anfroholic/eurosynth/README.md

# EuroSynth 🎛️🔊

A **kitchen-sink synthesizer voice in custom silicon** — a fully digital eurorack
synth voice taped out on the open-source **GlobalFoundries 180 nm (GF180MCU)** PDK with
the LibreLane RTL-to-GDSII flow.

<p align="center">
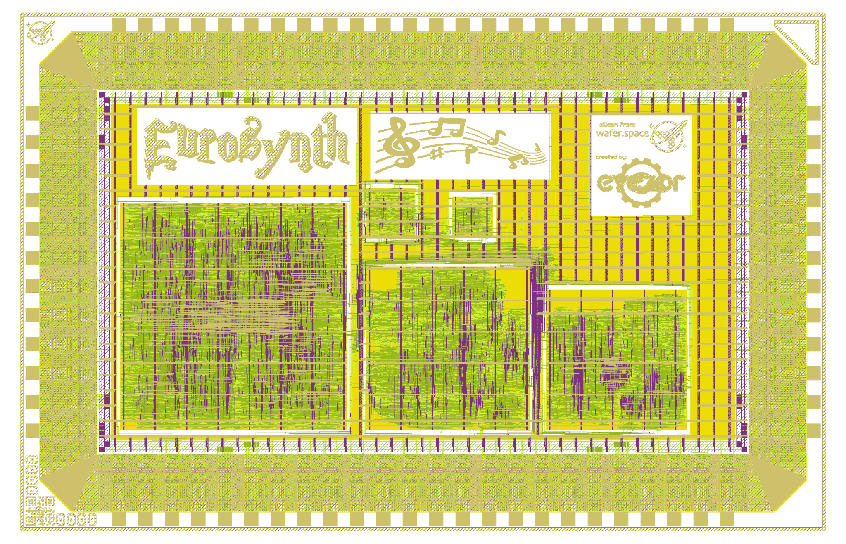
[picture p1: docs/img/die_render.png]
EuroSynth die render
  
</p>

A small, bulletproof **spine** owns the audio timing, mixes a bank of **isolated sound
engines**, and streams 16-bit audio to an external DAC. Engine #1 — a **Karplus-Strong
plucked string** — is verified *bit-exact* against a golden reference and hardened to a
**clean, manufacturable GDSII**:

> **DRC = 0 · LVS = 0 · antenna = 0 · power-grid = 0** — manufacturability report all-pass.
> Die 3.93 mm × 2.53 mm (9.95 mm²), 66,906 standard cells, 5 V.

### 🎧 Hear it in your browser

**▶ [Live playground → anfroholic.github.io/eurosynth/web](https://anfroholic.github.io/eurosynth/web/)**
— all five voices running live, no install. It executes the chip's **bit-exact integer
reference models** (`models/*_ref.py`) in WebAssembly via [PyScript](https://pyscript.net),
so what you hear is sample-for-sample what the silicon produces. Source: [web/](web/).

## 📖 Documentation

| Doc | What's in it |
|---|---|
| **[🎧 Live playground](https://anfroholic.github.io/eurosynth/web/)** | The chip's voices running in your browser — bit-exact reference models compiled to WebAssembly (PyScript). Source in [web/](web/). |
| **[docs/SHOWCASE.md](docs/SHOWCASE.md)** | The flagship write-up: what it is, the silicon achievement & signoff, architecture, the Karplus-Strong engine, specs, and pinout. **Start here.** |
| **[docs/HARDWARE_GUIDE.md](docs/HARDWARE_GUIDE.md)** | Build it: power/clock/reset, a sample circuit for **every pad**, a "hello world" first-light test, two audio output options, and a ready-to-run Arduino controller. |
| **[NOTES.md](NOTES.md)** | Design rationale — *why* it looks the way it does; the engine contract; the roadmap. |
| **[docs/karplus_strong.md](docs/karplus_strong.md)** | The KS engine spec: integer algorithm, fixed-point analysis, golden-vector test plan. |
| **[PLAN.md](PLAN.md) · [PROGRESS.md](PROGRESS.md)** | Build plan and the full status log (incl. the GDSII hardening run). |

## 🗂️ Source

| Path | Role |
|---|---|
| [src/synth_spine.sv](src/synth_spine.sv) | Timing spine: tick gen, voice mux, I2S serializer, bypass ramp |
| [src/ks_engine.sv](src/ks_engine.sv) | Karplus-Strong plucked-string engine |
| [src/chip_core.sv](src/chip_core.sv) | Pad-interface wiring (the `1x0p5` pin map) |
| [src/chip_top.sv](src/chip_top.sv) | Template top / I/O pad ring |
| [models/ks_ref.py](models/ks_ref.py) · [models/ks_golden.hex](models/ks_golden.hex) | Bit-exact reference model + golden vector |
| [tb/](tb/) | Self-checking testbenches (KS golden, spine round-trip, elaboration) |

## ⚡ 5-Minute Quickstart

> **Built on [@evezor's wafer.space Docker starter kit](https://github.com/evezor/wafer_space_docker_based_starter_kit)** —
> a beginner-friendly GF180MCU + wafer.space tutorial (itself built on the
> [wafer.space gf180mcu-project-template](https://github.com/wafer-space/gf180mcu-project-template)).
> EuroSynth uses that kit's exact Docker flow. **New to silicon? Do that tutorial first.**

The fastest path from nothing to a green simulation — proof the whole thing works
on your machine. You need only `docker` + `docker compose` (and `make`).

```bash
# 1. Get the code
git clone https://github.com/anfroholic/eurosynth.git
cd eurosynth

# 2. Build the simulation image (one-time; a few minutes)
make build-sim

# 3. Simulate the chip — the moment of truth
make sim
```

> ✅ **Green light:** `make sim` ends with `ALL STANDALONE TBS PASSED` and exits 0.
> If you got here, the kit works on your machine.

### Optional — produce a real layout

```bash
make pdk        # fetch the GF180MCU PDK (multi-GB, one-time)
make harden     # RTL → GDSII for the default slot (takes a while)
```

After `make harden`, the signed-off layout lands in `final/` — check
`final/manufacturability.rpt` (DRC / LVS / antenna) and `final/gds/chip_top.gds`.

> **No `make`?** On native Windows the same steps are the script wrappers:
> `bash scripts/sim_all.sh`, `bash scripts/pdk.sh`, `bash scripts/harden.sh`.

## 🛠️ Built with

GF180MCU PDK · LibreLane · OpenROAD · Yosys · Magic · KLayout · Netgen.

## 📜 License

Apache-2.0 (see [LICENSE](LICENSE) and [AUTHORS.md](AUTHORS.md)).
