anfroholic/eurosynth/docs/img/art_samples/00_source_greyscale.png

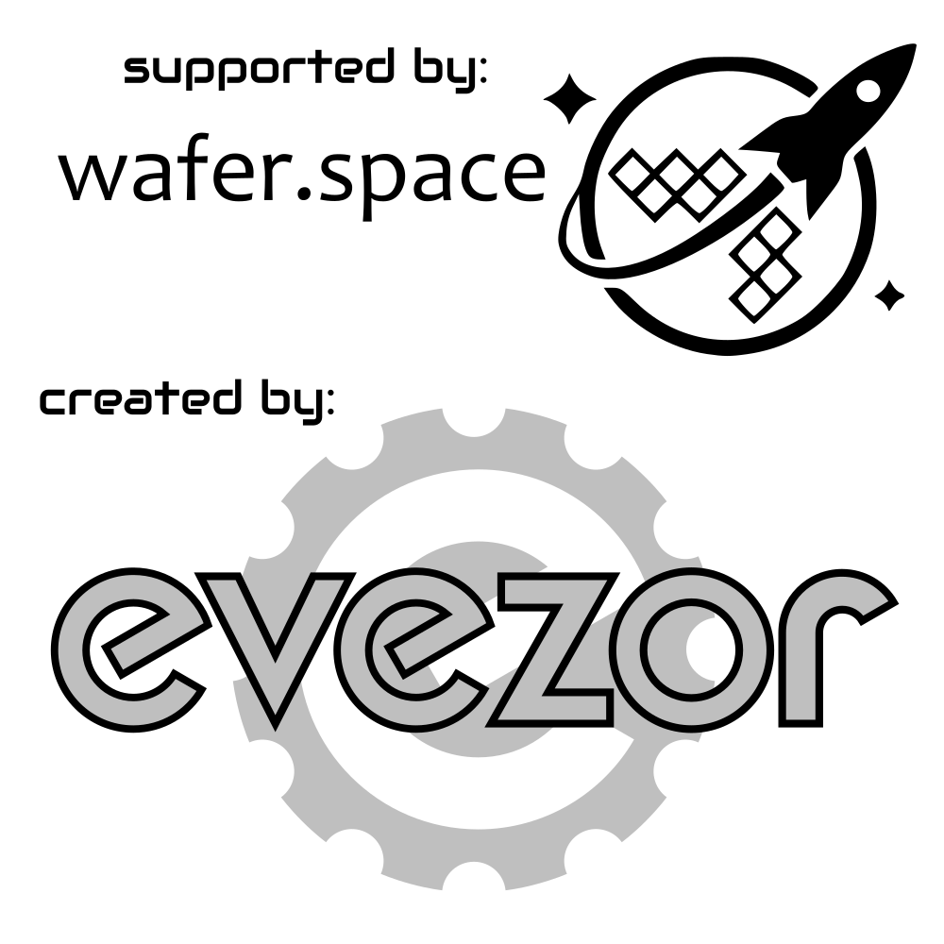
docs/img/art_samples/00_source_greyscale.png
