anfroholic/eurosynth/docs/img/art_samples/04_control_input.png

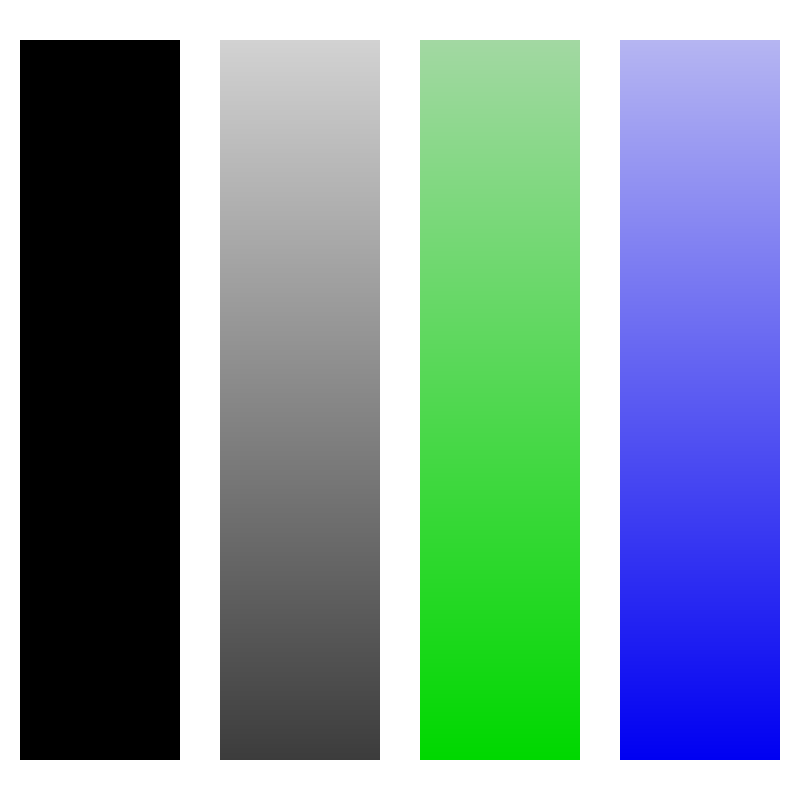
docs/img/art_samples/04_control_input.png
