anfroholic/eurosynth/docs/img/art_samples/05_control_output.png

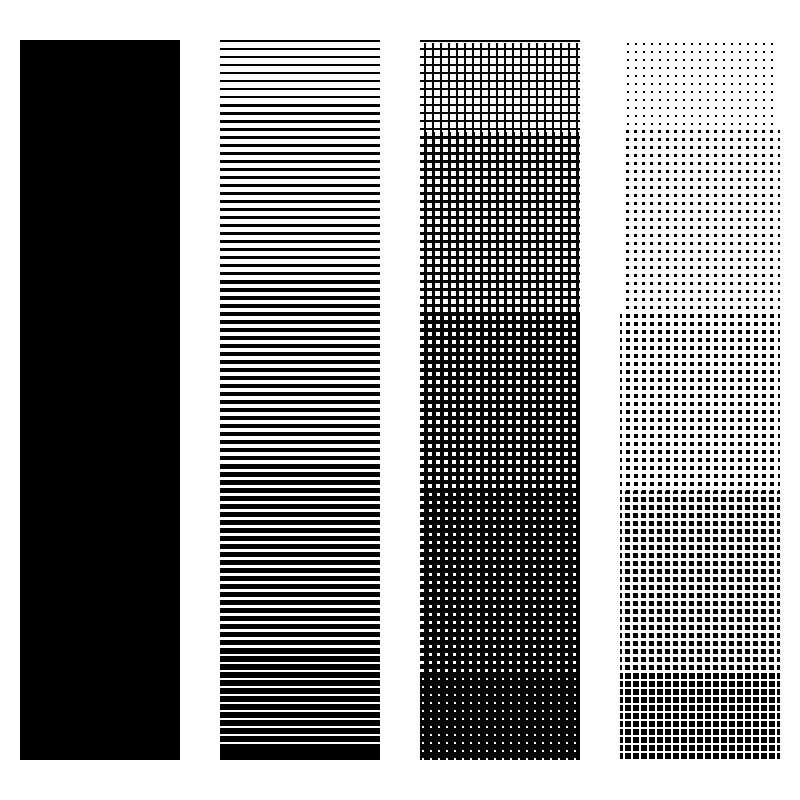
docs/img/art_samples/05_control_output.png
