anfroholic/eurosynth/docs/img/art_samples/06_proof_gradient.png

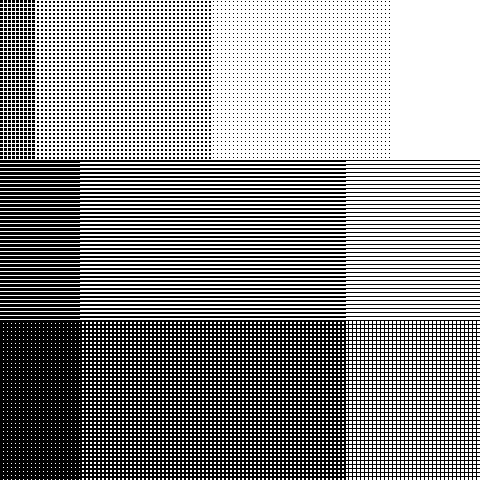
docs/img/art_samples/06_proof_gradient.png
