anfroholic/eurosynth/docs/img/art_samples/08_all_styles_swatch.png

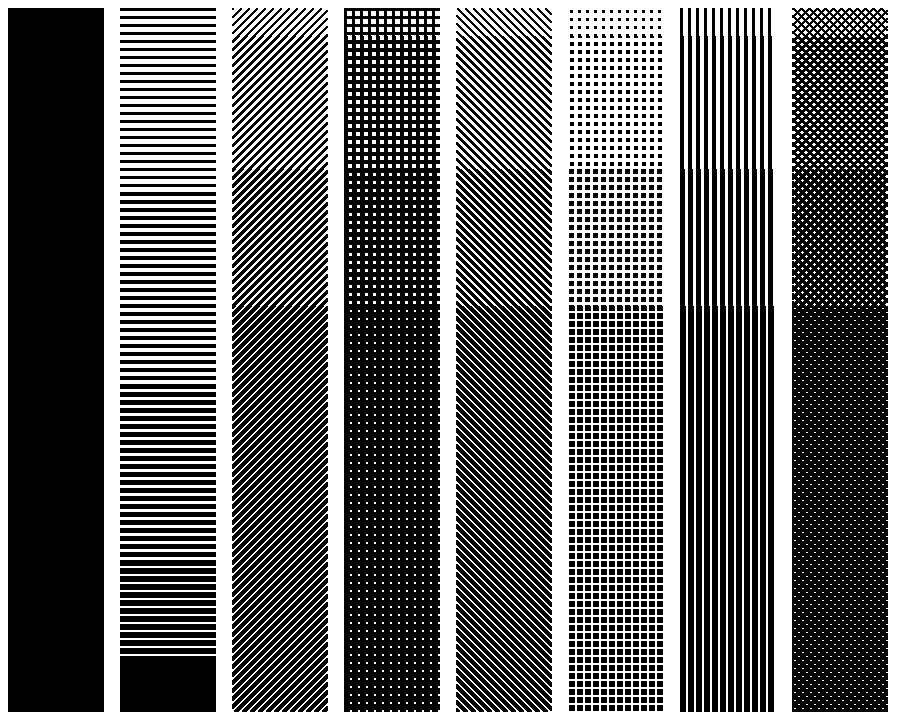
docs/img/art_samples/08_all_styles_swatch.png
