anfroholic/eurosynth/final_chip/chip_top.png

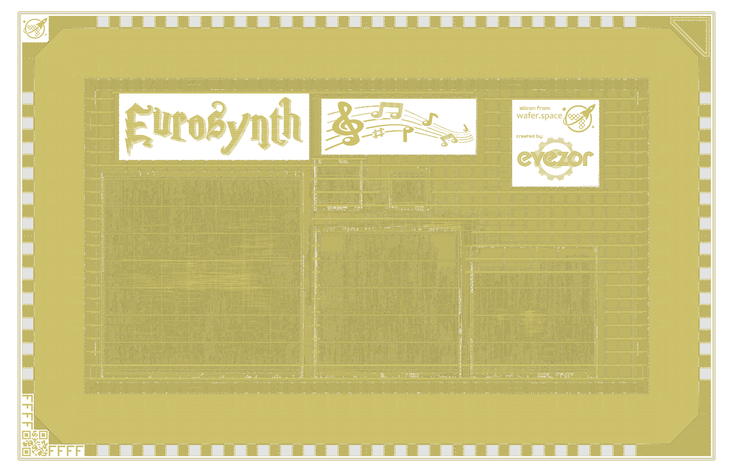
final_chip/chip_top.png
