anfroholic/eurosynth/ip/eurosynth_art/image/locations.png

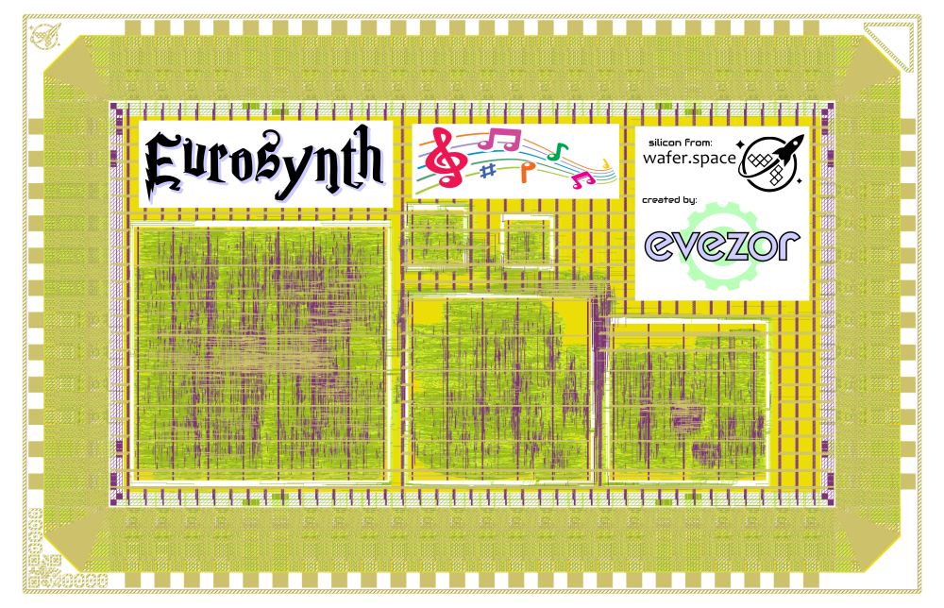
ip/eurosynth_art/image/locations.png
