anfroholic/eurosynth/ip/eurosynth_art/image/notes.png

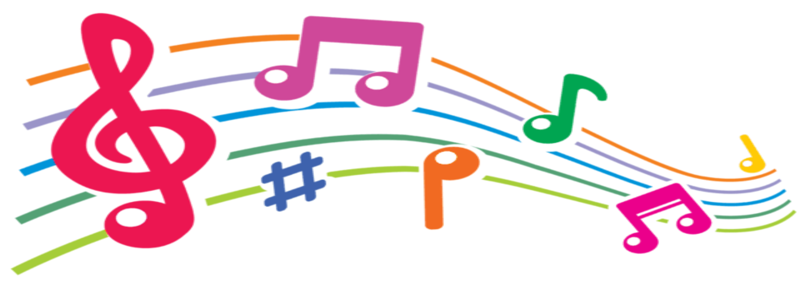
ip/eurosynth_art/image/notes.png
