anfroholic/eurosynth/ip/eurosynth_notes/preview.png

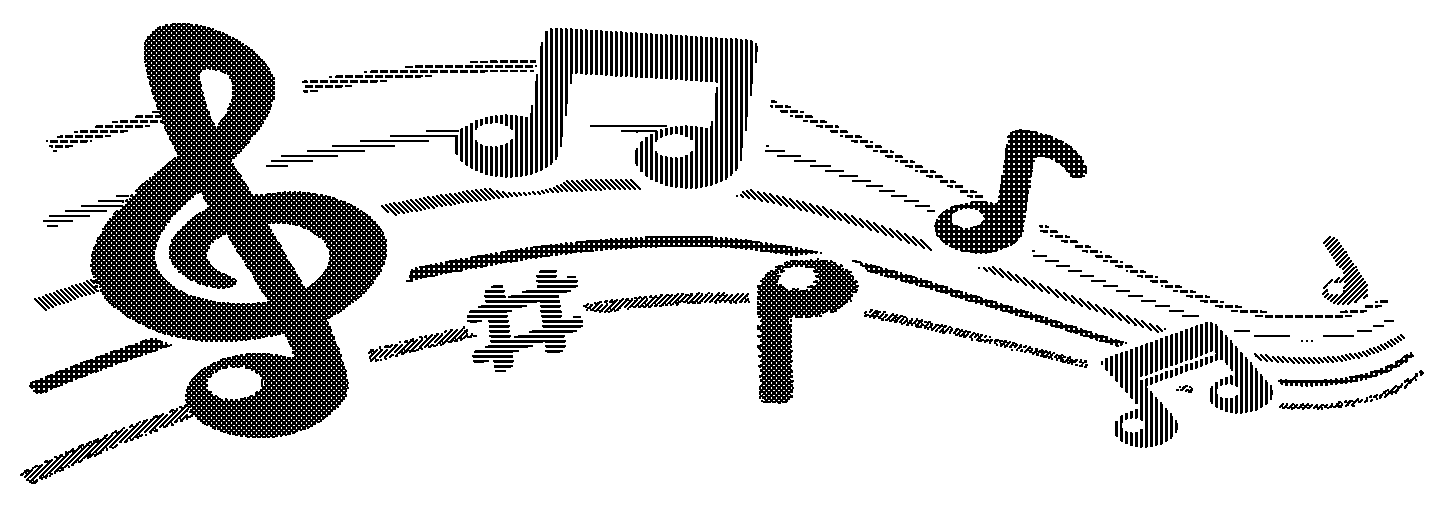
ip/eurosynth_notes/preview.png
