anfroholic/eurosynth/docs/img/art_samples/07_colored_control_result.png

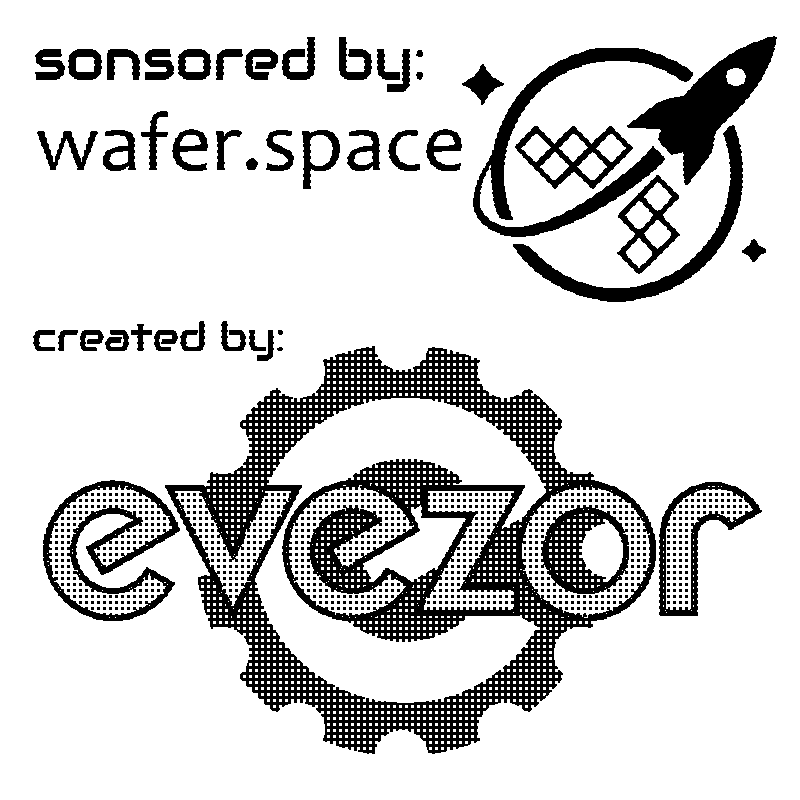
docs/img/art_samples/07_colored_control_result.png
