anfroholic/eurosynth/src/synth_spine.sv

// SPDX-License-Identifier: Apache-2.0
//
// synth_spine: the bulletproof shared backbone of the kitchen-sink synth chip.
//
//   - Generates the audio sample rate (one `sample_tick` pulse per frame).
//   - Hosts a voice-select mux: exactly one source drives the output at a time,
//     so engines never interfere (isolation = bounded blast radius).
//   - Provides a `bypass` test-ramp source: a known sawtooth that proves the
//     serializer + external DAC path is alive during bring-up, independent of
//     any real engine.
//   - Serializes the 16-bit sample as an I2S-style stream (bclk / ws / sd).
//
// Real engines (neural, chaos, SID, bytebeat, ...) bolt on later as extra mux
// inputs. A bug in any one of them stays in that one — it cannot sink the chip.

`default_nettype none

module synth_spine #(
    parameter SAMPLE_W  = 16,
    parameter BCLK_DIV  = 16,        // clk cycles per bclk half-period -> fs = clk / (64*BCLK_DIV)
    parameter RAMP_STEP = 16'sd1024, // bypass sawtooth increment per sample
    parameter SAW_INC   = 16'd2179,  // placeholder voice 1 phase increment
    parameter SQ_INC    = 16'd1303   // placeholder voice 2 phase increment
)(
    input  wire clk,
    input  wire rst_n,                 // active low

    // --- control (real-time play on pins; deep config over SPI, below) ---
    input  wire [2:0] voice_sel,       // 0=bypass,1=saw,2=square,3=SID,4=Karplus-Strong,5=chaos,6=bytebeat,7=neural
    input  wire       bypass_en,       // force the test ramp regardless of voice_sel

    // --- Karplus-Strong control (voice 4); ks_period doubles as the shared
    //     10-bit pitch bus for the SID/neural voices (see instances below) ---
    input  wire       ks_pluck,        // 1-clk strobe: (re)excite the string
    input  wire [9:0] ks_period,       // delay-line length / shared pitch (10-bit)

    // --- SPI config port: deep per-engine parameters + neural weights ---
    input  wire       spi_sclk,        // SPI slave clock          (bidir pad, in)
    input  wire       spi_mosi,        // SPI master-out-slave-in   (bidir pad, in)
    input  wire       spi_csn,         // SPI chip-select, active low (bidir pad, in)
    output wire       spi_miso,        // SPI master-in-slave-out   (bidir pad, out)

    // --- I2S-style serial audio output (to an external DAC) ---
    output wire i2s_bclk,
    output wire i2s_ws,
    output wire i2s_sd,

    // --- debug / bring-up taps ---
    output reg                       sample_tick,  // 1-clk pulse at each frame start
    output reg  signed [SAMPLE_W-1:0] sample_dbg,  // the sample being serialized this frame
    output wire                      heartbeat     // slow toggle: "the chip is alive"
);

    // ---------------------------------------------------------------------
    // Bit-clock generation + falling-edge strobe (our shift event)
    // ---------------------------------------------------------------------
    localparam DW = (BCLK_DIV <= 1) ? 1 : $clog2(BCLK_DIV);
    reg [DW-1:0] div_cnt;
    reg          bclk_q;
    reg          bclk_fall;           // 1-clk strobe when bclk goes 1 -> 0

    always @(posedge clk) begin
        if (!rst_n) begin
            div_cnt   <= '0;
            bclk_q    <= 1'b0;
            bclk_fall <= 1'b0;
        end else begin
            bclk_fall <= 1'b0;
            if (div_cnt == BCLK_DIV[DW-1:0] - 1'b1) begin
                div_cnt <= '0;
                bclk_q  <= ~bclk_q;
                if (bclk_q == 1'b1) bclk_fall <= 1'b1;  // about to fall
            end else begin
                div_cnt <= div_cnt + 1'b1;
            end
        end
    end

    assign i2s_bclk = bclk_q;

    // ---------------------------------------------------------------------
    // Frame / bit sequencing + MSB-first shift register
    // 32 bits per frame: [0..15] = left channel, [16..31] = right channel.
    // Mono source is duplicated to both channels.
    // ---------------------------------------------------------------------
    reg [4:0]            bit_idx;     // index of the bit currently presented
    reg signed [15:0]    shiftreg;
    reg signed [15:0]    frame_sample;

    wire [4:0] next_idx = bit_idx + 5'd1;

    always @(posedge clk) begin
        if (!rst_n) begin
            bit_idx      <= 5'd31;    // so the first shift event lands on bit 0
            shiftreg     <= '0;
            frame_sample <= '0;
            sample_dbg   <= '0;
            sample_tick  <= 1'b0;
        end else begin
            sample_tick <= 1'b0;
            if (bclk_fall) begin
                bit_idx <= next_idx;
                if (next_idx == 5'd0) begin            // start of a new frame (left bit 0)
                    frame_sample <= sample_in;
                    shiftreg     <= sample_in;
                    sample_dbg   <= sample_in;
                    sample_tick  <= 1'b1;
                end else if (next_idx == 5'd16) begin  // right channel, same mono sample
                    shiftreg <= frame_sample;
                end else begin
                    shiftreg <= {shiftreg[14:0], 1'b0}; // shift MSB out
                end
            end
        end
    end

    assign i2s_ws = bit_idx[4];        // 0 for bits 0..15, 1 for bits 16..31
    assign i2s_sd = shiftreg[15];      // MSB first

    // ---------------------------------------------------------------------
    // Sources
    // ---------------------------------------------------------------------
    // Bypass test ramp (bring-up insurance): a clean sawtooth.
    reg signed [15:0] ramp;
    always @(posedge clk) begin
        if (!rst_n)            ramp <= '0;
        else if (sample_tick)  ramp <= ramp + RAMP_STEP;
    end

    // Placeholder voice 1: phase-accumulator sawtooth.
    reg [15:0] saw_phase;
    always @(posedge clk) begin
        if (!rst_n)            saw_phase <= '0;
        else if (sample_tick)  saw_phase <= saw_phase + SAW_INC;
    end
    wire signed [15:0] osc_saw = $signed(saw_phase ^ 16'h8000); // unsigned ramp -> centered saw

    // Placeholder voice 2: phase-accumulator square.
    reg [15:0] sq_phase;
    always @(posedge clk) begin
        if (!rst_n)            sq_phase <= '0;
        else if (sample_tick)  sq_phase <= sq_phase + SQ_INC;
    end
    wire signed [15:0] osc_sq = sq_phase[15] ? 16'sh7FFF : -16'sh8000;

    // Voice 4: Karplus-Strong plucked-string engine (advances on sample_tick).
    wire signed [15:0] ks_sample;
    ks_engine u_ks (
        .clk(clk), .rst_n(rst_n),
        .sample_tick(sample_tick),
        .pluck(ks_pluck), .period(ks_period),
        .sample(ks_sample)
    );

    // ---------------------------------------------------------------------
    // SPI config port: a NREG x 16 register file written over SPI. Each engine
    // reads its slice combinationally (config map in docs/engines_plan.md). The
    // cfg write-event taps (cfg_we/addr/wdata) route neural weights (0x40-0x4F)
    // straight into the neural engine's weight-load port.
    // ---------------------------------------------------------------------
    localparam NREG       = 128;
    localparam A_BYTEBEAT = 'h10;          // config word: bytebeat (voice 6)
    localparam A_CHAOS    = 'h11;          // config word: chaos    (voice 5)
    localparam A_SID0     = 'h12;          // config word: SID voice 0 (voice 3)
    localparam A_SID1     = 'h13;          // config word: SID voice 1
    localparam A_SID2     = 'h14;          // config word: SID voice 2
    localparam A_NEURAL   = 'h15;          // config word: neural morph (voice 7)
    localparam A_NN_W_LO  = 'h40;          // neural weight-load window (0x40..0x4F)
    localparam A_NN_W_HI  = 'h4F;
    wire [NREG*16-1:0] cfg_flat;
    wire        cfg_we;
    wire [6:0]  cfg_addr;
    wire [15:0] cfg_wdata;
    spi_config #(.NREG(NREG)) u_spi (
        .clk(clk), .rst_n(rst_n),
        .spi_sclk(spi_sclk), .spi_mosi(spi_mosi), .spi_csn(spi_csn),
        .spi_miso(spi_miso),
        .cfg_flat(cfg_flat), .cfg_we(cfg_we), .cfg_addr(cfg_addr), .cfg_wdata(cfg_wdata)
    );

    // Voice 6: bytebeat (free-running integer formula; config 0x10).
    wire [15:0] cfg_bytebeat = cfg_flat[A_BYTEBEAT*16 +: 16];
    wire signed [15:0] bb_sample;
    bytebeat u_bb (
        .clk(clk), .rst_n(rst_n), .sample_tick(sample_tick),
        .formula_sel(cfg_bytebeat[3:0]),   // 0x10[3:0]
        .t_inc      (cfg_bytebeat[11:4]),  // 0x10[11:4]
        .sample(bb_sample)
    );

    // Voice 5: chaos (fixed-point logistic / CA / Lorenz; config 0x11).
    wire [15:0] cfg_chaos = cfg_flat[A_CHAOS*16 +: 16];
    wire signed [15:0] chaos_sample;
    chaos_engine u_chaos (
        .clk(clk), .rst_n(rst_n), .sample_tick(sample_tick),
        .map_sel(cfg_chaos[1:0]),    // 0x11[1:0]
        .rate   (cfg_chaos[7:2]),    // 0x11[7:2]
        .r_seed (cfg_chaos[15:8]),   // 0x11[15:8]
        .sample(chaos_sample)
    );

    // Voice 3: SID-homage 3 voices. Per-voice timbre from config 0x12-0x14;
    // the 3 phase increments come from the shared 10-bit pitch bus (ks_period),
    // with a small detune on v1 and v2 one octave down -> a playable patch.
    wire [15:0] cfg_sid0 = cfg_flat[A_SID0*16 +: 16];
    wire [15:0] cfg_sid1 = cfg_flat[A_SID1*16 +: 16];
    wire [15:0] cfg_sid2 = cfg_flat[A_SID2*16 +: 16];
    wire [15:0] pitch16  = {ks_period, 6'b0};        // 10-bit pitch -> 16-bit phase inc
    wire signed [15:0] sid_sample;
    sid_engine u_sid (
        .clk(clk), .rst_n(rst_n), .sample_tick(sample_tick),
        .v0_freq(pitch16),
        .v1_freq(pitch16 + 16'd97),                  // slight detune (chorus)
        .v2_freq({1'b0, pitch16[15:1]}),             // one octave down
        .v0_wave(cfg_sid0[2:0]), .v1_wave(cfg_sid1[2:0]), .v2_wave(cfg_sid2[2:0]),
        .v0_pw  (cfg_sid0[15:8]), .v1_pw(cfg_sid1[15:8]), .v2_pw(cfg_sid2[15:8]),
        .ring_en({cfg_sid2[3], cfg_sid1[3], cfg_sid0[3]}),  // bit i -> voice i
        .sync_en({cfg_sid2[4], cfg_sid1[4], cfg_sid0[4]}),
        .sample(sid_sample)
    );

    // Voice 7: neural morphing oscillator. morph from config 0x15[7:0]; pitch
    // from the shared pitch bus. Weights load at elaboration (reset defaults) and
    // can be overwritten over SPI: a config write into the 0x40-0x4F window is
    // routed to the engine's weight-load port (addr 0x40 -> weight 0).
    wire [15:0] cfg_neural = cfg_flat[A_NEURAL*16 +: 16];
    wire        nn_w_we    = cfg_we && (cfg_addr >= A_NN_W_LO[6:0]) && (cfg_addr <= A_NN_W_HI[6:0]);
    wire [5:0]  nn_w_addr  = cfg_addr[5:0];          // 0x40..0x4F -> 0..15
    wire signed [15:0] nn_sample;
    neural_osc u_neural (
        .clk(clk), .rst_n(rst_n), .sample_tick(sample_tick),
        .pitch(ks_period),               // shared pitch bus
        .morph(cfg_neural[7:0]),         // 0x15[7:0]
        .w_we(nn_w_we), .w_addr(nn_w_addr), .w_wdata(cfg_wdata),
        .sample(nn_sample)
    );

    // ---------------------------------------------------------------------
    // Voice-select mux: ONE source reaches the output at a time.
    // ---------------------------------------------------------------------
    reg signed [15:0] sel_sample;
    always @(*) begin
        case (voice_sel)
            3'd0:    sel_sample = ramp;
            3'd1:    sel_sample = osc_saw;
            3'd2:    sel_sample = osc_sq;
            3'd3:    sel_sample = sid_sample;
            3'd4:    sel_sample = ks_sample;
            3'd5:    sel_sample = chaos_sample;
            3'd6:    sel_sample = bb_sample;
            3'd7:    sel_sample = nn_sample;
            default: sel_sample = 16'sd0;   // silence
        endcase
    end

    wire signed [15:0] sample_in = bypass_en ? ramp : sel_sample;

    // ---------------------------------------------------------------------
    // Heartbeat: a slow toggle so bring-up can confirm the chip is clocking.
    // ---------------------------------------------------------------------
    reg [9:0] hb_cnt;
    always @(posedge clk) begin
        if (!rst_n)            hb_cnt <= '0;
        else if (sample_tick)  hb_cnt <= hb_cnt + 1'b1;
    end
    assign heartbeat = hb_cnt[9];

endmodule

`default_nettype wire
