anfroholic/eurosynth/tb/tb_synth_spine.sv

// SPDX-License-Identifier: Apache-2.0
//
// tb_synth_spine: drive the spine, then act as an I2S *receiver* (like the DAC
// would) and check that the decoded left-channel word equals the sample the
// spine said it was sending (sample_dbg). If the round-trip matches, the
// sample-tick -> mux -> serializer path is proven end to end.

`timescale 1ns/1ps
`default_nettype none

module tb_synth_spine;

    localparam SAMPLE_W = 16;
    localparam BCLK_DIV = 2;   // tiny divider so frames fly by in sim

    reg clk = 1'b0;
    reg rst_n = 1'b0;
    reg [2:0] voice_sel = 3'd0;
    reg bypass_en = 1'b1;
    reg ks_pluck = 1'b0;
    reg [9:0] ks_period = 10'd16;

    // SPI config pins (idle: csn high, sclk/mosi low). Driven by spi_write().
    reg  spi_sclk = 1'b0;
    reg  spi_mosi = 1'b0;
    reg  spi_csn  = 1'b1;
    wire spi_miso;

    wire i2s_bclk, i2s_ws, i2s_sd, heartbeat, sample_tick;
    wire signed [SAMPLE_W-1:0] sample_dbg;

    synth_spine #(.SAMPLE_W(SAMPLE_W), .BCLK_DIV(BCLK_DIV)) dut (
        .clk(clk), .rst_n(rst_n),
        .voice_sel(voice_sel), .bypass_en(bypass_en),
        .ks_pluck(ks_pluck), .ks_period(ks_period),
        .spi_sclk(spi_sclk), .spi_mosi(spi_mosi), .spi_csn(spi_csn), .spi_miso(spi_miso),
        .i2s_bclk(i2s_bclk), .i2s_ws(i2s_ws), .i2s_sd(i2s_sd),
        .sample_tick(sample_tick), .sample_dbg(sample_dbg),
        .heartbeat(heartbeat)
    );

    always #10 clk = ~clk;   // 50 MHz

    // ---- I2S receiver (mimics the external DAC) -----------------------------
    reg        bclk_d = 1'b0;
    wire       bclk_rise = i2s_bclk & ~bclk_d;
    reg signed [15:0] rx_acc = '0;
    reg        ws_seen = 1'b1;

    integer checks = 0, fails = 0;
    reg ks_nonzero  = 1'b0;  // set if any KS-voice (voice_sel==4) frame decodes non-zero
    reg sid_nonzero = 1'b0;  // set if any SID-voice (voice_sel==3) frame decodes non-zero
    reg ch_nonzero  = 1'b0;  // set if any chaos-voice (voice_sel==5) frame decodes non-zero
    reg bb_nonzero  = 1'b0;  // set if any bytebeat-voice (voice_sel==6) frame decodes non-zero

    always @(posedge clk) begin
        bclk_d <= i2s_bclk;
        if (bclk_rise) begin
            if (i2s_ws == 1'b0)                     // sampling the left channel
                rx_acc <= {rx_acc[14:0], i2s_sd};   // MSB-first
        end
        // detect end of left channel (ws 0 -> 1): rx_acc now holds 16 bits
        ws_seen <= i2s_ws;
        if (ws_seen == 1'b0 && i2s_ws == 1'b1 && rst_n) begin
            checks = checks + 1;
            if (voice_sel == 3'd4 && rx_acc !== 0) ks_nonzero  <= 1'b1;
            if (voice_sel == 3'd3 && rx_acc !== 0) sid_nonzero <= 1'b1;
            if (voice_sel == 3'd5 && rx_acc !== 0) ch_nonzero  <= 1'b1;
            if (voice_sel == 3'd6 && rx_acc !== 0) bb_nonzero  <= 1'b1;
            if (rx_acc === sample_dbg) begin
                $display("  frame %0d: DAC decoded %0d  (intended %0d)  OK",
                         checks, rx_acc, sample_dbg);
            end else begin
                fails = fails + 1;
                $display("  frame %0d: DAC decoded %0d  (intended %0d)  MISMATCH",
                         checks, rx_acc, sample_dbg);
            end
        end
    end

    // ---- stimulus -----------------------------------------------------------
    initial begin
        $dumpfile("spine.vcd");
        $dumpvars(0, tb_synth_spine);

        repeat (8) @(posedge clk);
        rst_n = 1'b1;

        $display("\n[1] BYPASS test ramp (bring-up insurance path):");
        bypass_en = 1'b1; voice_sel = 3'd0;
        wait_frames(6);

        $display("\n[2] Voice 1 = sawtooth oscillator (via mux):");
        bypass_en = 1'b0; voice_sel = 3'd1;
        wait_frames(6);

        $display("\n[3] Voice 2 = square oscillator (via mux):");
        voice_sel = 3'd2;
        wait_frames(6);

        $display("\n[4] Voice 3 = SID 3-voice (configured over SPI, then selected):");
        spi_write(8'h12, 16'h8000);     // v0: saw,      pw=0x80
        spi_write(8'h13, 16'h8009);     // v1: triangle + ring (bit3), pw=0x80
        spi_write(8'h14, 16'h4002);     // v2: pulse,    pw=0x40
        bypass_en = 1'b0; voice_sel = 3'd3;
        wait_frames(8);
        if (!sid_nonzero) begin
            fails = fails + 1;
            $display("  [4] FAIL: SID voice produced only silence (sid_nonzero never set)");
        end else begin
            $display("  [4] OK: SPI config + SID reached the serializer with non-zero output");
        end

        $display("\n[5] Voice 4 = Karplus-Strong (pluck then select):");
        ks_period = 10'd16;
        @(posedge clk); ks_pluck = 1'b1; @(posedge clk); ks_pluck = 1'b0;
        bypass_en = 1'b0; voice_sel = 3'd4;
        wait_frames(6);
        if (!ks_nonzero) begin
            fails = fails + 1;
            $display("  [5] FAIL: KS voice produced only silence (ks_nonzero never set)");
        end else begin
            $display("  [5] OK: KS voice reached the serializer with non-zero output");
        end

        $display("\n[5b] Voice 5 = chaos (configured over SPI, then selected):");
        spi_write(8'h11, 16'hE000);     // config 0x11: r_seed=0xE0 (r~3.875), map_sel=0
        bypass_en = 1'b0; voice_sel = 3'd5;
        wait_frames(8);
        if (!ch_nonzero) begin
            fails = fails + 1;
            $display("  [5b] FAIL: chaos voice produced only silence (ch_nonzero never set)");
        end else begin
            $display("  [5b] OK: SPI config + chaos reached the serializer with non-zero output");
        end

        $display("\n[6] Voice 6 = bytebeat (configured over SPI, then selected):");
        spi_write(8'h10, 16'h0011);     // config 0x10: formula_sel=1, t_inc=1
        bypass_en = 1'b0; voice_sel = 3'd6;
        wait_frames(8);
        if (!bb_nonzero) begin
            fails = fails + 1;
            $display("  [6] FAIL: bytebeat voice produced only silence (bb_nonzero never set)");
        end else begin
            $display("  [6] OK: SPI config + bytebeat reached the serializer with non-zero output");
        end

        $display("\n==== %0d frames checked, %0d mismatches ====", checks, fails);
        if (fails == 0) $display("==== SPINE OK: every decoded sample matched ====\n");
        else            $display("==== SPINE FAIL ====\n");
        $finish;
    end

    // wait for N frame-start ticks
    task wait_frames(input integer n);
        integer k;
        begin
            for (k = 0; k < n; k = k + 1) @(posedge sample_tick);
        end
    endtask

    // Drive one SPI Mode-0 frame {addr[7:0], data[15:0]}, MSB-first, at a rate
    // far slower than clk (so the 2-FF synchronizer in spi_config sees it). MOSI
    // changes while sclk is low; the slave samples on the rising edge. csn frames
    // the transfer and the write commits on csn rising.
    task spi_write(input [7:0] addr, input [15:0] data);
        reg [23:0] frame;
        integer i;
        begin
            frame = {addr, data};
            spi_csn = 1'b0; #200;
            for (i = 23; i >= 0; i = i - 1) begin
                spi_mosi = frame[i];
                #100; spi_sclk = 1'b1;   // rising edge: slave samples MOSI
                #200; spi_sclk = 1'b0;   // falling edge
                #100;
            end
            spi_csn = 1'b1;              // frame end -> config[addr] <= data
            #200;
        end
    endtask

    // safety timeout
    initial begin
        #2_000_000;
        $display("TIMEOUT");
        $finish;
    end

endmodule

`default_nettype wire
