anfroholic/eurosynth/(commit log)

2026-06-16 baseline: handoff RTL + notes (spine, chip_core, self-checking TB)
    Pristine starting point as received: the bulletproof synth spine, its
    chip_core pad wiring, the standalone I2S round-trip testbench, and the
    design brief. main holds only this baseline; all build work happens on
    the overnight/ branch.
2026-06-16 phase0/scaffold: docker sim image, sim wrapper, plan, progress tracker
    Verified tonight (human awake): eurosynth-sim image builds, spine TB passes
    green in-container (21 frames, 0 mismatches), git push works.
    - docker/Dockerfile.sim : iverilog + cocotb sim image (no GDSII toolchain)
    - scripts/sim.sh : one-liner to run anything in the image w/ repo mounted
    - PLAN.md : autonomous execution plan + make-librelane runbook
    - PROGRESS.md : chunk tracker / resume anchor
    - .gitattributes/.gitignore : LF discipline + ignore sim/GDSII/PDK artifacts
2026-06-16 phase0: mark de-risk + baseline complete
2026-06-16 phase1a/layout: recon done, move RTL to src/ & TB to tb/
    Template recon complete (cloned to sibling ref dir). Key finding recorded in
    PROGRESS: cocotb make-sim + librelane need the PDK, so tonight's autonomous
    verification uses standalone Icarus TBs; full chip_top sim + GDSII is the human
    PDK session. Established target layout (src/, tb/); spine TB still green
    (21 frames, 0 mismatches) from the new paths.
2026-06-16 phase2a: KS spec + bit-exact model + golden; retarget to 1x0p5 slot
    - docs/karplus_strong.md : Karplus-Strong design spec (engine contract,
    exact integer algorithm, fixed-point/overflow
    proof, golden-vector test plan, area caveat)
    - models/ks_ref.py : pure-Python bit-exact reference; deterministic
    - models/ks_golden.hex : 256-sample golden vector (verified in-container;
    first sample -7568 == 0xe270)
    - docs/template_integration.md : durable recon (so no re-clone needed) + 1x0p5
    pad budget; pad-category split is soft, only the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
2026-06-16 phase2c: Karplus-Strong engine RTL (src/ks_engine.sv)
    Implements the spec's exact integer KS: Galois LFSR pluck seeding (one
    write/clk, completes before first tick), sustain step with signed arithmetic
    shift feedback ((out+prev)*2047)>>>12, 2's-complement wrap store, runtime
    clamp of period to [2,NMAX-1], registered output held between ticks.
    Verified: elaborates clean under iverilog -g2012 -Wall (exit 0). Bit-exact
    golden comparison via tb/tb_ks_engine.sv is the next chunk.
2026-06-16 phase2d: KS golden-vector testbench — engine bit-exact verified (0 mismatches)
    tb/tb_ks_engine.sv loads models/ks_golden.hex ($readmemh), plucks period=48,
    runs 256 sustain steps and compares each registered sample to the oracle:
    ==== 256 samples checked, 0 mismatches ==== ==== KS OK ====
    Main-context verification caught a real clock-edge race in the agent's first TB
    (blocking strobe at posedge -> double-step, ptr 0->2). Fixed by driving the
    sample_tick (and pluck) strobes on the negedge so they are stable at the posedge
    the DUT samples. The RTL design was correct (confirmed via an internal probe);
    only the harness timing was adjusted.
    Karplus-Strong engine (Phase 2) is complete and p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
    [tb_ks_engine.sv]
2026-06-16 docs: retarget PLAN to 1x0p5 (status banner + make librelane runbook SLOT)
2026-06-16 phase3a/wire-in: instantiate ks_engine in spine, voice_sel=4 — verified spine TB
    Wire the bit-exact Karplus-Strong engine into synth_spine as voice 4:
    - new spine ports ks_pluck / ks_period[9:0] (driven by chip_core in 3b)
    - ks_engine instance fed by the shared sample_tick
    - mux case 3'd4 -> ks_sample
    tb_synth_spine phase [5] plucks the string then selects voice 4. Verified
    in-container (Icarus): SPINE OK, 27 frames, 0 mismatches; phases [1]-[4]
    byte-identical to baseline (no regression); voice-4 round-trip decoded
    -7568 == the KS golden first-ringing sample; ks_nonzero guard makes
    "SPINE OK" impossible on a silent KS voice.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
2026-06-16 phase3b: chip_core 1x0p5 pin map — KS controls via bidir-input pads, verified elab
    Redesign chip_core internal pad wiring for the 1x0p5 slot (4 input / 46 bidir /
    4 analog). Port list + parameter names unchanged (chip_top contract preserved).
    - input_in[2:0]=voice_sel, input_in[3]=bypass_en (all 4 input pads used)
    - bidir direction mask via a static generate loop: bits [15:5] are INPUTS
    (ks_pluck=bidir_in[5], ks_period=bidir_in[15:6]), all other bits OUTPUTS;
    bidir_ie = ~bidir_oe
    - i2s_sd/bclk/ws, heartbeat, sample_tick, sample_dbg[15:0] on output bidir pads
    - KS controls routed into u_spine via the new ks_pluck/ks_period ports
    - tie-off retargeted to the now-unused bidir_in bits
    Add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
    [chip_core.sv, tb_chip_core_elab.sv]
2026-06-16 phase1b': import wafer.space template skeleton, swap in our core (1x0p5)
    Adopt the gf180mcu-project-template tree so the repo is make-librelane-ready,
    keeping our verified design as the user core. Imported 46 tracked template
    files (Makefile, flake.{nix,lock}, shell.nix, librelane/, cocotb/, ip/ tapeout
    macros, src/chip_top.sv, src/slot_defines.svh, scripts/padring.py, AUTHORS,
    LICENSE). Did NOT import the template's example src/chip_core.sv (kept ours),
    its README, or .github/ CI (nix-based; would fail on every push).
    Design swaps / config:
    - DEFAULT_SLOT = 1x0p5 (Makefile)
    - librelane/config.yaml VERILOG_FILES += synth_spine.sv, ks_engine.sv
    - cocotb/chip_top_tb.py: added the same RTL sou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
    [chip_top.sv, config.yaml]
2026-06-16 phase5/docs: record GDSII hardening greenlight + env recon, set up nixos/nix rig
    PROGRESS Phase 5 + PLAN §12: WSL2 path ruled out (sudo needs password; Docker
    not integrated into WSL). Pivoted to a long-lived Docker nixos/nix container
    (root can populate /nix without host sudo); template flake pulls librelane +
    EDA tools from the fossi-foundation binary cache. Devshell materialization
    running in background.
2026-06-16 phase4b: update NOTES.md to verified 1x0p5 + Karplus-Strong state
    Pin map -> 1x0p5 (KS pluck/period on bidir-input pads [15:5]); Status section
    rewritten to the proven facts (KS bit-exact 256/256; spine voice-4 decodes the
    -7568 golden first sample; chip_core ELAB OK); Files table refreshed; template
    integration marked done; KS marked engine #1 done in the roadmap. Run commands
    point at the container-based standalone TBs.
2026-06-16 phase5a: librelane devshell up (LibreLane v3.1.0.dev1); PDK fetch in progress
    nix develop materialized the full EDA toolchain (~7.4 GB) from the
    fossi-foundation binary cache inside the eurosynth-harden container — no source
    builds. librelane/make/ciel/iverilog on PATH. clone-pdk (gf180mcuD) now
    downloading to the /pdk volume in the background.
2026-06-16 phase5b: gf180mcuD PDK fetched (retry after transient timeout); 5c hardening started
    PDK enabled at /pdk (4.0 GB). make librelane running in background from a
    container-local /build copy; yosys synthesis confirmed underway (processing the
    KS delay-line inferred memory). RTL→GDSII flow in progress.
2026-06-16 phase5c-fix: drop SRAM PDN source from pdn_cfg.tcl (core is SRAM-free)
    make librelane run 1 reached stage 22/83 (GeneratePDN) then failed with
    [PDN-1030] Unable to find instance: i_chip_core.sram_0. Root cause: pdn_cfg.tcl
    unconditionally sources pdn_5v_sram.tcl / pdn_3v3_sram.tcl, which define PDN
    grids for the SRAM macro instances we removed. The earlier SRAM strip
    (macros_*.yaml) missed this file. Fix: pdn_cfg.tcl no longer sources the SRAM
    PDN scripts (left dormant for future SRAM use).
    Resuming the run from OpenROAD.GeneratePDN to skip the ~6 h yosys synthesis of
    the KS 1024x16 flop delay line.
2026-06-16 phase5d: lean KS variant NMAX 256 (bit-exact; golden unchanged)
    Per the human's call (finish the 1024 baseline GDS, then ship a leaner design),
    shrink the Karplus-Strong delay line from 1024x16 to 256x16 flops (16 Kbit ->
    4 Kbit) for a far faster/smaller hardening flow.
    - src/ks_engine.sv: default NMAX 1024->256; `period` port decoupled from NMAX to
    a FIXED [9:0] (per the engine contract) and clamped internally to [2, NMAX-1],
    so chip_core's pin map (ks_period = bidir_in[15:6]) is untouched.
    - models/ks_ref.py: NMAX=256. Golden regenerated -> BYTE-IDENTICAL (the golden
    pluck period PGOLDEN=48 <= 255, so the math is unchanged).
    - docs/karplus_strong.md, NOTES.md, tb comments updated (4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
    [ks_engine.sv, synth_spine.sv, tb_ks_engine.sv]
2026-06-17 phase5e: 256 lean hardened to clean GDSII (DRC/LVS/antenna all pass)
    256-deep KS design (SLOT=1x0p5) ran RTL->GDSII through LibreLane v3.1.0.dev1
    on gf180mcuD and passed full physical signoff: Magic/KLayout/routing DRC=0,
    density=0, LVS=0 (0 device/net/pin diffs), antenna=0, PDN=0. manufacturability.rpt
    = Antenna/LVS/DRC all Passed. final/ deliverable extracted (gitignored).
    Setup-timing caveat: WNS -21.7ns vs template default 25MHz clk_PAD (256:1 tap
    mux); hold clean. Non-issue for audio (advances on ~48kHz sample_tick).
    Overnight fixes documented: (1) ps/pgrep broken in harden container -> use /proc;
    (2) missing pmap crashed PDK klayout antenna+lvs decks -> installed procps,
    resumed --fr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
2026-06-17 docs: add showcase package — SHOWCASE, HARDWARE_GUIDE, README, diagrams
    Rich, presentation-ready documentation for the taped-out design:
    - README.md: landing page with die render + signoff headline + doc map
    - docs/SHOWCASE.md: flagship write-up (what/why, clean-signoff table, die photo,
    architecture, Karplus-Strong engine, full specs, functional pinout, verification,
    the honest 25MHz timing caveat, engine roadmap)
    - docs/HARDWARE_GUIDE.md: per-pad sample circuits (power/clock/reset, voice_sel,
    pluck debounce, period DIP map), hello-world first-light, two audio paths
    (R-2R parallel DAC + I2S w/ level shift), Arduino controller sketch, BOM,
    troubleshooting
    - docs/img/: architectur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
2026-06-17 engines: plan for full roster + SPI config port (branch kickoff)
    Adds docs/engines_plan.md: voice-slot map, SPI slave protocol + config register
    map, per-engine specs (bytebeat, chaos, SID, neural morphing osc), control
    architecture (pins + SPI), verification rail, build order. Neural = morphing
    oscillator, control = pins + SPI-loadable config/weights (per human call).
2026-06-17 engines: SPI config port + Bytebeat voice 6 (bit-exact, wired into spine)
    SPI slave (Mode 0, MSB-first 24-bit {addr,data} frames; 0x5713 miso liveness
    signature) drives a 128x16 config regfile (cfg_flat); engines read their slice
    combinationally. Bytebeat (voice 6) = free-running integer formula generator
    mapped to signed-16, configured from 0x10 (formula_sel/t_inc).
    Standalone (self-verified, 0 mismatches each): tb_spi_config 36 checks / SPI OK;
    tb_bytebeat 256 samples / BYTEBEAT OK (4 classic formulas, all exercised).
    Integration: spine instantiates spi_config + bytebeat, mux case 3'd6; chip_core
    pin map extends to SPI bidir 32/33/34 (in) + 36 (miso out). Regression green:
    SPINE OK (38 f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
2026-06-17 engines: Chaos voice 5 (bit-exact, wired into spine)
    Fixed-point chaos engine: Q16 logistic map (r from 0x11[15:8]), rule-30 CA-
    perturbed logistic, and a Q12 Euler Lorenz; map_sel/rate/r_seed from config 0x11.
    Reset re-seeds x; r is read live so SPI can sweep it between ticks.
    Standalone (self-verified): tb_chaos_engine 255 samples / CHAOS OK, 0 mismatches
    (all three maps exercised; golden deterministic across regenerations).
    Integration: spine mux case 3'd5, driven by cfg 0x11. Regression green: SPINE OK
    (49 frames, 0 mismatches; SPI-config'd voice 5 non-silent + round-trips).
    [chaos_engine.sv, synth_spine.sv, tb_chaos_engine.sv, tb_synth_spine.sv]
2026-06-17 engines: SID-homage voice 3 (bit-exact, wired into spine)
    3 phase-accumulator voices (saw/triangle/pulse+PW/LFSR-noise) with ring-mod
    (neighbor MSB into the triangle fold) and hard sync (neighbor overflow resets
    the accumulator), summed and scaled >>2. Per-voice timbre from config 0x12-0x14;
    the 3 phase increments come from the shared pitch bus (detune on v1, octave down
    on v2).
    Standalone (self-verified): tb_sid_engine 256 samples / SID OK, 0 mismatches
    (saw, triangle, pulse, noise, ring, and sync all exercised).
    Integration: spine mux case 3'd3 (was the silent slot); the old "[4] silence"
    spine phase becomes a real SID test. Regression green: SPINE OK (64 frames,
    0 mismatches; SPI-config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
    [sid_engine.sv, sid_voice.sv, synth_spine.sv, tb_sid_engine.sv, tb_synth_spine.sv]
2026-06-17 engines: Neural morphing oscillator voice 7 (bit-exact, wired into spine)
    Fixed-point MLP (5->8->8->1, ReLU, Q1.14) whose `morph` (config 0x15) sweeps a
    sine->saw->square->pulse timbre continuum. Features = 4 phase harmonics from a
    256-entry sine LUT + morph. One time-shared MAC sequences ~139 clk/sample; the
    output is registered and stable by the next tick. Weights trained offline (numpy,
    seeded) and embedded via $readmemh; SPI writes into the 0x40-0x4F window overwrite
    the first weights live.
    Standalone (self-verified): tb_neural_osc 255 samples / NEURAL OK, 0 mismatches
    (RTL forward pass == quantized model across a morph sweep). Reproducible end to
    end: train -> ref/golden -> 0 mismatche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
    [neural_osc.sv, synth_spine.sv, tb_chip_core_elab.sv, tb_neural_osc.sv]
2026-06-17 engines: register new RTL in librelane + cocotb source lists
    Add spi_config, bytebeat, chaos_engine, sid_voice, sid_engine, neural_osc to
    VERILOG_FILES (config.yaml) and the cocotb RTL sources so the tree is
    hardening/sim-ready with the full roster. Note the neural_osc $readmemh weight
    path must be made absolute before a GDSII run (flagged inline); full multi-engine
    hardening on the half slot is a follow-up.
2026-06-17 docs: kitchen-sink engine roster complete + verified
    engines_plan.md: voice map 3/5/6/7 -> done; Status section rewritten to "roster
    complete + verified" with per-engine verify+commit table, integration/regression
    summary, pin-map additions, and follow-up caveats.
    PROGRESS.md: banner flipped to COMPLETE; new Phase E (Ea-Eg) with verify results +
    commit hashes; commit-log entries appended.
    NOTES.md: roadmap marks Chaos/SID/Bytebeat/Neural + SPI port done; pin map adds SPI
    bidir 32/33/34 (in) + 36 (miso out) and notes ks_period doubles as the shared pitch
    bus; Files table + Status section updated.
2026-06-17 neural: bake weights into RTL via generated include (synthesis-safe)
    Replace the runtime $readmemh("models/neural_weights.hex") in neural_osc with
    `include "neural_weights_init.svh" — an initial block of mem[i]=16'h.... assignments
    generated by neural_train.py alongside the hex (bit-identical, 385 words: 256 sine
    LUT + 129 MLP weights). Removes the cwd-relative file dependency that would break a
    hardening run (synth cwd is the run dir, not the repo root); the include resolves
    from src/ exactly like slot_defines.svh. Memory stays a writable reg, so the SPI
    weight-load path is unchanged.
    Bit-exact preserved: NEURAL OK (255, 0 mismatches), SPINE OK (64 frames), ELAB OK.
    Standalone iverilog n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
    [neural_osc.sv]
2026-06-17 audio: render_audio.py — listenable WAV previews from the ref models
    Drives each bit-exact reference model (ks/bytebeat/chaos/sid/neural) with a short
    musical scenario and writes previews/*.wav (48 kHz mono 16-bit) for ear-checking the
    engines before silicon — incl. neural.wav (a slow morph sweep sine->saw->square->
    pulse) and tour.wav (montage). stdlib-only. previews/ is gitignored (large binaries).
2026-06-17 neural: make LUT functions pure so yosys synthesizes (bit-exact)
    yosys rejected neural_osc with "Non-constant expression in constant function":
    harm_phase/lut_index read the module `phase` reg directly, which the yosys
    frontend treats as a non-constant in a constant-function context (iverilog
    tolerates it). Pass `phase` in as an explicit function argument instead — math is
    identical. yosys now reads+elaborates the full chip_core hierarchy (all 5 engines
    + SPI) with `check` = 0 problems. Bit-exact preserved: NEURAL OK (255), SPINE OK
    (64 frames), ELAB OK.
    [neural_osc.sv]
2026-06-17 docs: Phase F — full-roster hardening prep + run in flight
    Record the two yosys-frontend fixes (baked neural weights aca1c77, pure LUT
    functions a5b674a) and the detached full-roster `make librelane` run now in
    yosys-synthesis: rig/flakes/proc gotchas, build+run dirs, log sentinel, and the
    fresh-session check commands. Area/fit on the half slot is the open question.
2026-06-17 harden: bound KLayout DRC/antenna workers (was OOM-killing decks)
    The full-roster signoff DRC launched workers:max (=48) and OOM-killed several
    deck workers on the large layout (deep-mode DRC over ~1M polygons/layer),
    yielding empty deck results ("unexpected token at ''"). Bound DRC + antenna
    workers to 6. Not a design issue — the GDS placed, routed, and streamed (die
    ~9.95M um^2, same slot-bound area as the 256 run); only the checker over-
    parallelized.
    [config.yaml]
2026-06-17 docs: Phase F complete — full-roster GDSII signed off (1x0p5)
    The whole 5-engine + SPI chip placed, routed, and streamed a GDS on the half slot
    (ROSTER2_EXIT=0). Signoff: Magic/KLayout/routing DRC 0, LVS 0/0, hold 0 vios — all
    clean; 57.5% util (fits comfortably). Caveats: 1 residual antenna violation, and
    setup timing violated at 25 MHz (expected; audio runs <<25 MHz). KLayout DRC OOM
    (workers:max) fixed by bounding workers to 6 + resume from cached DRC step.
    Deliverable in final_roster/ (gitignored).
2026-06-18 harden: bump DRT antenna repair 10/10 -> 20/40 to clear residual net16049
    First full-roster route left one stubborn antenna net (net16049, side-area ratio
    400 VIOLATED) -> 4 KLayout ANT.16 signoff violations. Raise DRT_ANTENNA_REPAIR_ITERS
    to 20 and DRT_ANTENNA_REPAIR_MARGIN to 40% for more aggressive jogging/diode
    insertion during detailed routing. Re-run resumes from OpenROAD.DetailedRouting.
2026-06-18 harden: revert DRT antenna knobs to known-good 10/10
    The 20/40 bump caused DPL-0036: the single repair diode (ANTENNA_152) for the
    residual antenna net has no legal site near the gate (local congestion), and a
    bigger margin only makes more unplaceable diodes. It's a placement problem, not a
    routing one. Restore the 10/10 the full run completed on; clearing the net needs a
    re-place (heuristic diode insertion / lower density), pending a human call.
    [config.yaml]
2026-06-18 docs: Phase Fe — antenna re-place plan + Docker-restart resume notes
    Record the antenna root cause (net16049 needs diode ANTENNA_152 that DPL can't
    legalize locally), the reverted margin experiment, the human's choice to retry via
    a re-place (heuristic diode insertion / lower density, resume --from
    OpenROAD.GlobalPlacement), and the post-Docker-restart procedure (docker start
    eurosynth-harden; never docker rm it). Memory updated to match.
2026-06-18 harden: enable heuristic diode insertion to clear net16049 antenna
    Pre-empt the unplaceable post-route repair diode by inserting diodes proactively
    before detailed routing: RUN_HEURISTIC_DIODE_INSERTION + HEURISTIC_ANTENNA_THRESHOLD
    130um. The Odb.HeuristicDiodeInsertion composite step legalizes with displacement,
    so net16049's diode gets a home (vs DPL-0036 from the post-route repair). Resume
    from that step -> skips the slow CTS/post-CTS resizer. DRT repair stays 10/10.
    [config.yaml]
2026-06-18 harden: disable heuristic diodes again (cleared antenna but broke LVS ports)
    Heuristic diode insertion (130um) DID clear net16049 -> 0/0 antenna, but the
    re-routed netlist then failed netgen TOP-LEVEL port matching on the 46 symmetric
    bidir pads (all device classes + sub-cell pin lists reported equivalent -> a netgen
    symmetry artifact, not a real short/open). That's a worse signoff status than v1's
    single waivable antenna net, so revert to the known-good 10/10 config that produced
    the clean roster-v1 (DRC/LVS/hold all 0). Decision on which to ship pending.
    [config.yaml]
2026-06-18 harden: jumper-only DRT antenna repair to clear net16049 cleanly
    Best both-clean lever: DRT_ANTENNA_REPAIR_JUMPER_ONLY fixes antennas by hopping the
    net to a higher metal layer instead of inserting a diode. No diode cell, no util
    bump, minimal placement/route change vs roster-v1 -> clears net16049 without the
    756-diode flood that broke netgen pad port-matching. Resume from
    OpenROAD.DetailedRouting (skips synth/place/CTS/resizer).
    [config.yaml]
2026-06-18 chore: adopt project-template 1.5.3 (CoB pad fix + foundry antenna fix)
    Pull the wafer.space gf180mcu-project-template 1.5.3 update:
    - PDK gf180mcuD: f6bfbd4d -> 019cf7a3 (Makefile). Ports the missing
    foundry-standard-cell antenna-insertion fix from the wafer.space PDK
    fork -- targets exactly the cell class of our lone residual antenna
    net (net16049, a dlyb_1 delay buffer).
    - LibreLane dev: 531569a2 -> 3131cc55 (flake.lock). Fixes the padring
    script regression that left N/S bond pads off-center by 0.5um, so the
    layout matches the default CoB padring (precheck 1.7.0 --cob pad mask).
    - ciel: bump + pin to 2.5.0 (flake.lock), required to fetch the new PDK.
    Antenna repair: drop DRT_AN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
    [config.yaml]
2026-07-04 recover from power outage
2026-07-05 Adopt wafer.space density-rule update: PDK d658698b (template 1.5.7 / precheck 1.7.1)
    The legacy wafer.space fork's density rules hadn't been upstreamed to Open
    PDKs; template 1.5.7 + precheck 1.7.1 pin PDK d658698b to fix that. Template's
    LibreLane pin resolves to 3.1.0.dev2 -- the image we already use -- so this is
    a verification-only update (no re-harden).
    - scripts/pdk.sh: PDK_COMMIT 019cf7a3 -> d658698b
    - scripts/precheck.sh (new): run the CoB precheck via the official
    ghcr.io/wafer-space/gf180mcu-precheck image (our harden image lacks the
    qrcode/pillow deps its Generate-ID stage needs, and the official image is
    the exact environment the platform reruns)
    - .gitignore: precheck-1.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
